maasijam/MONOFA/README.md

# MONOFA
A [Norns](https://monome.org/norns/) for Eurorack

It's based on a ["Fates Norns"](https://github.com/okyeron/fates) combined with an [Ornament & Crime](https://github.com/mxmxmx/O_C) (Captain Midi App) for Midi2CV and CV2Midi. The O_C ([MF-X2](MF-X2/)) has six additional gate outputs and a micro usb jack on the front panel. The [MF-X1](MF-X1/) boosts the norns signal to modular synth signal level and attenuates eurorack level to line level (for the norns input). The two expansion modules can be connected to the [MONOFA](MONOFA/) on the back.

|MONOFA|MF-X1|MF-X2|
|---|---|---|
|[Gerbers, BOM and images](MONOFA/)|[Gerbers, BOM and images](MF-X1/)|[Gerbers, BOM and images](MF-X2/)|

<br />

**Disclaimer**: This is a DIY project. Use at your own risk.<br />
<br /><br />
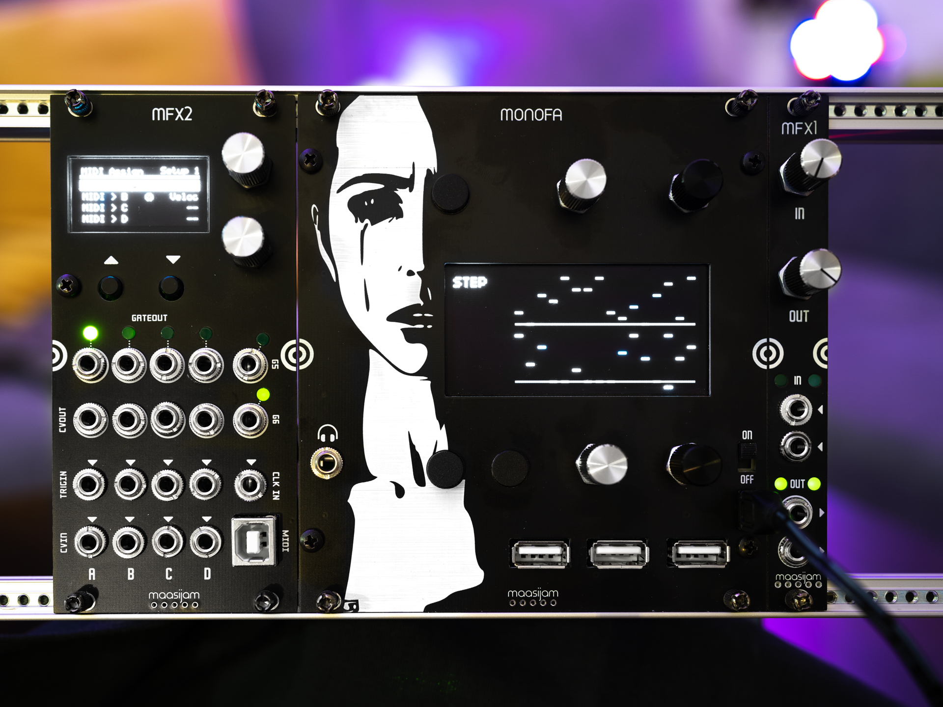
[picture p1: images/monofa_maasijam.jpg]
maasijam monofa


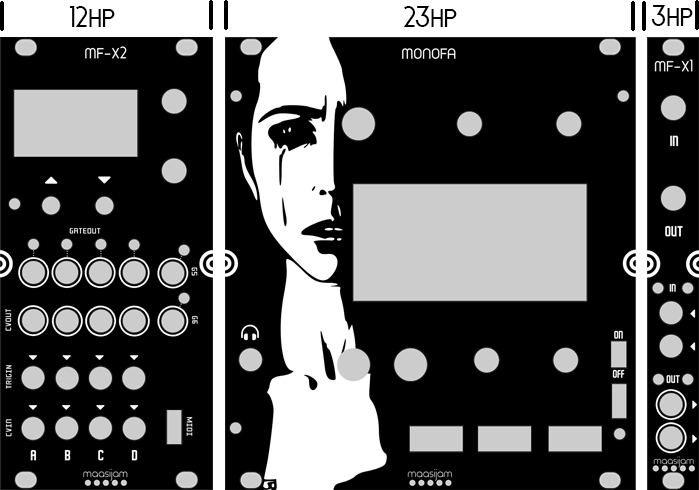
[picture p2: images/HPs.png]
maasijam monofa hp


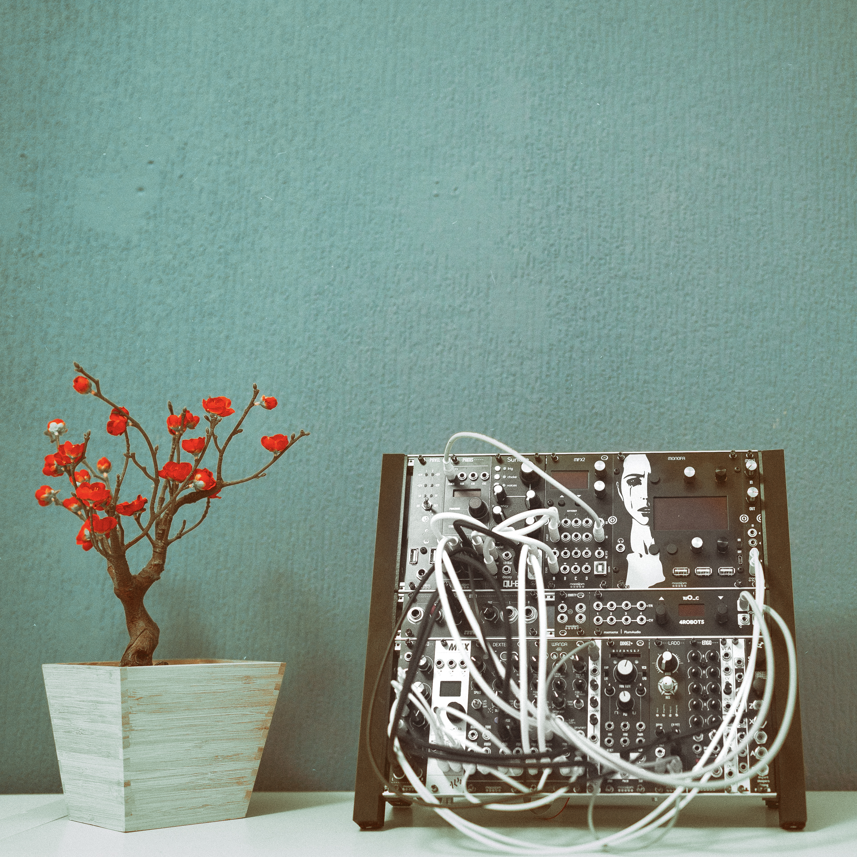
[picture p3: images/maasijam_monofa.jpg]
maasijam monofa
