maasijam/MONOFA/MF-X1/README.md

# MF-X1

Expander module for the MONOFA to boost line level to modular level and attenuates modular level to line level (for the MONOFA input). 
The MF-X1 can be connected to the MONOFA on the back.

### Notes:

This module only makes sense in combination with the [MONOFA](../MONOFA/) module.

<h3>Gerbers</h3>

[Gerber files for panel, front and back pcb](Gerber/)

<h3>BOM</h3>

[Bill of materials as CSV](BOM_mf-x1_v1.0revB.csv)
<br />
<br />

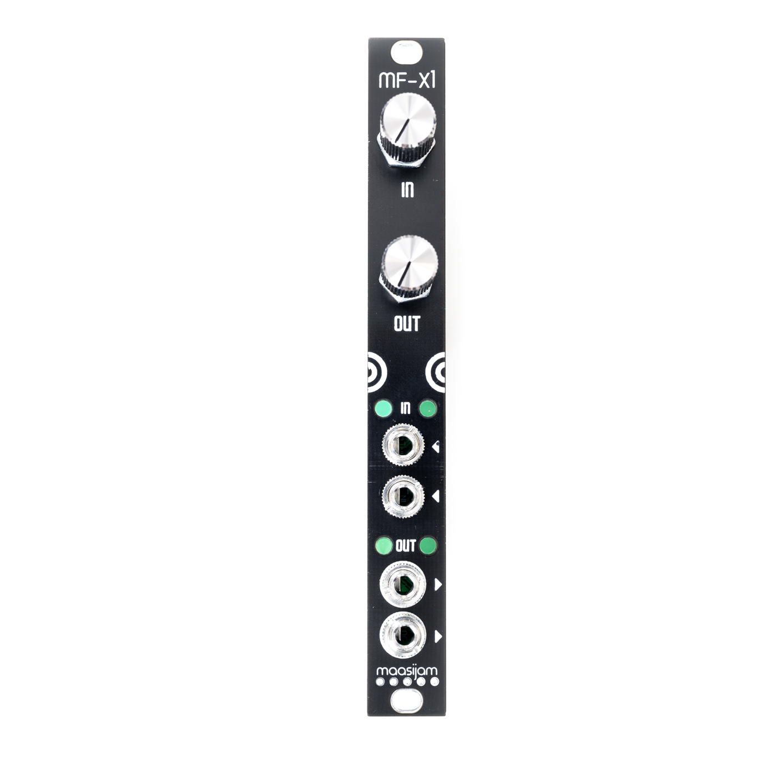
[picture p4: MF-X1/Images/mf-x1_maasijam-00307.jpg]
maasijam mf-x1


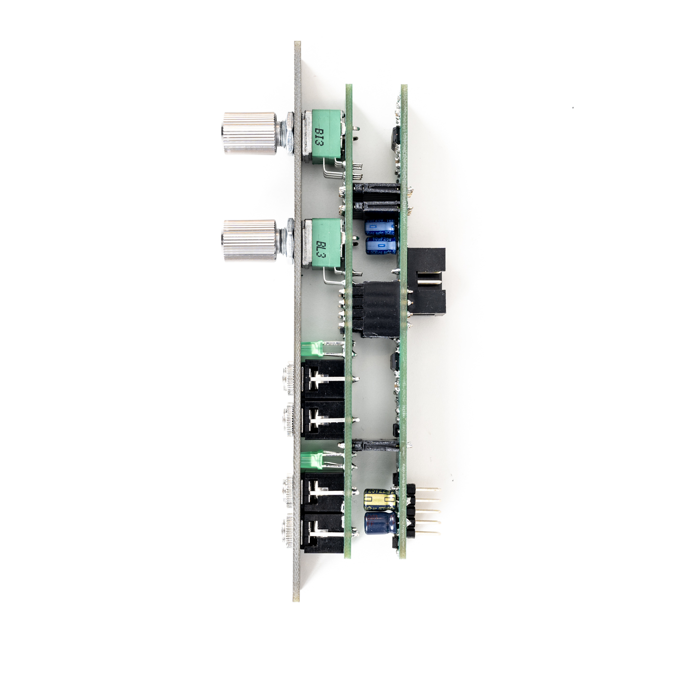
[picture p5: MF-X1/Images/mf-x1_maasijam-00308.jpg]
maasijam mf-x1


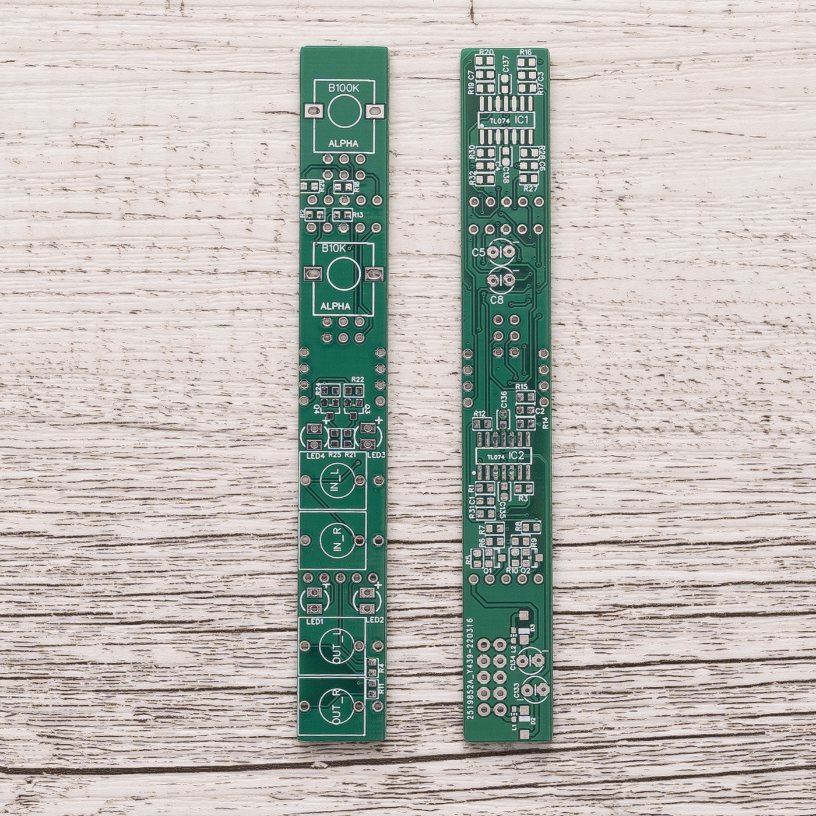
[picture p6: MF-X1/Images/mf-x1_maasijam-00284.jpg]
maasijam mf-x1
