maasijam/MONOFA/MONOFA/Readme.md

# MONOFA

A norns for eurorack.

### Notes:

You need the expander module [MF-X1](../MF-X1/) for stereo audio in and out. The two modules can be connected to each other on the back.

<h3>Gerbers</h3>

[Gerber files for panel, main and helper pcbs](Gerber/)
<br />

<h3>BOM</h3>

[Bill of materials as CSV](BOM_monofa_v1.0_revE.csv)
<br />

<br />

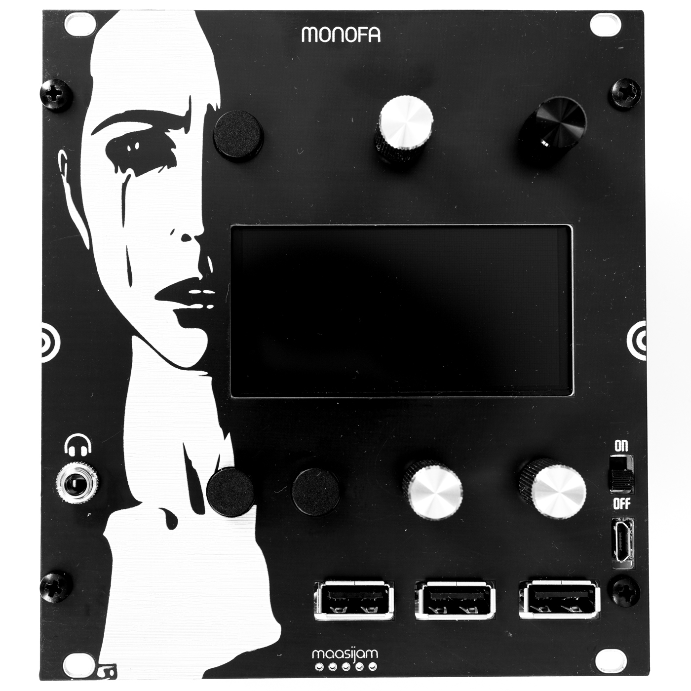
[picture p7: MONOFA/Images/monofa_maasijam-00364.jpg]
maasijam monofa


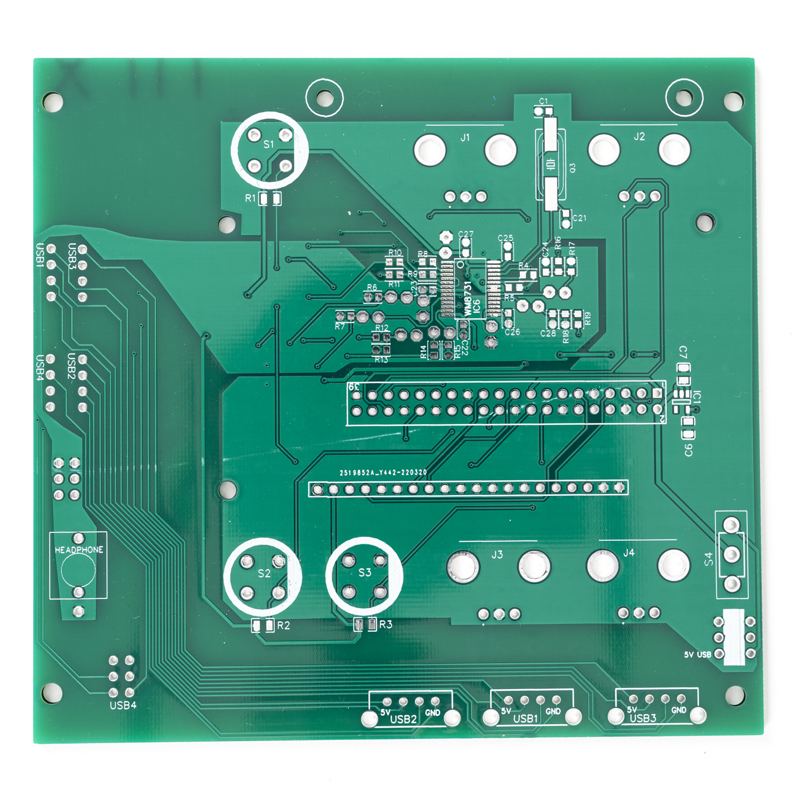
[picture p8: MONOFA/Images/monofa_maasijam-00362.jpg]
maasijam monofa


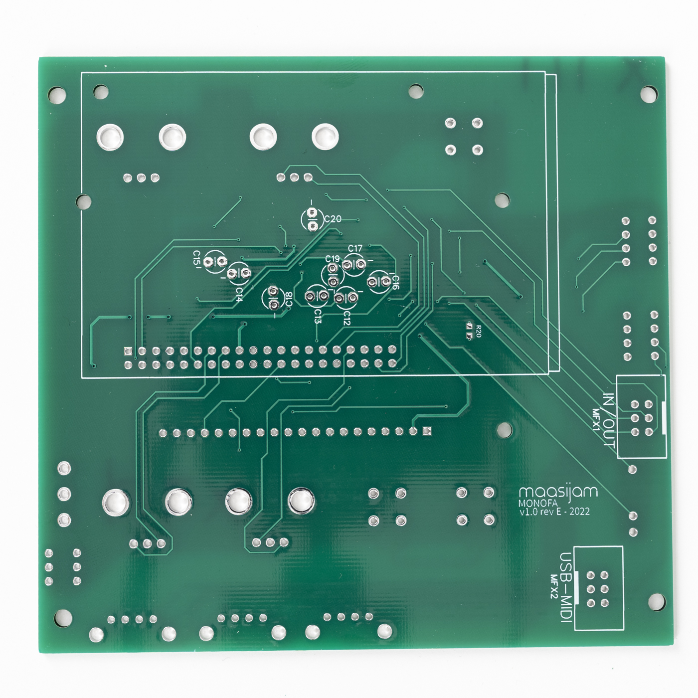
[picture p9: MONOFA/Images/monofa_maasijam-00363.jpg]
maasijam monofa


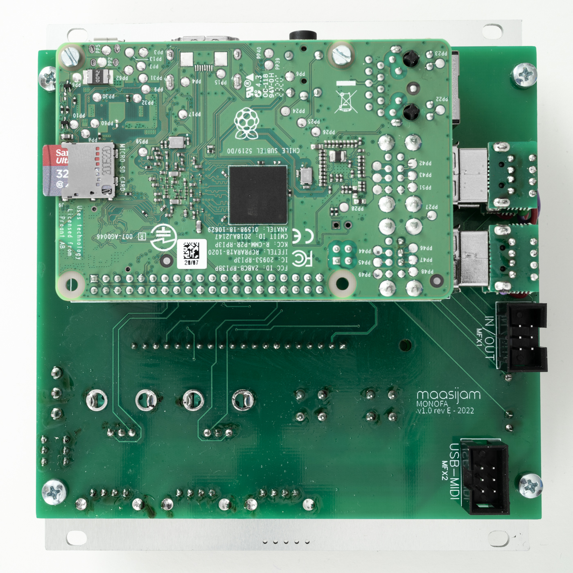
[picture p10: MONOFA/Images/monofa_maasijam-00365.jpg]
maasijam monofa


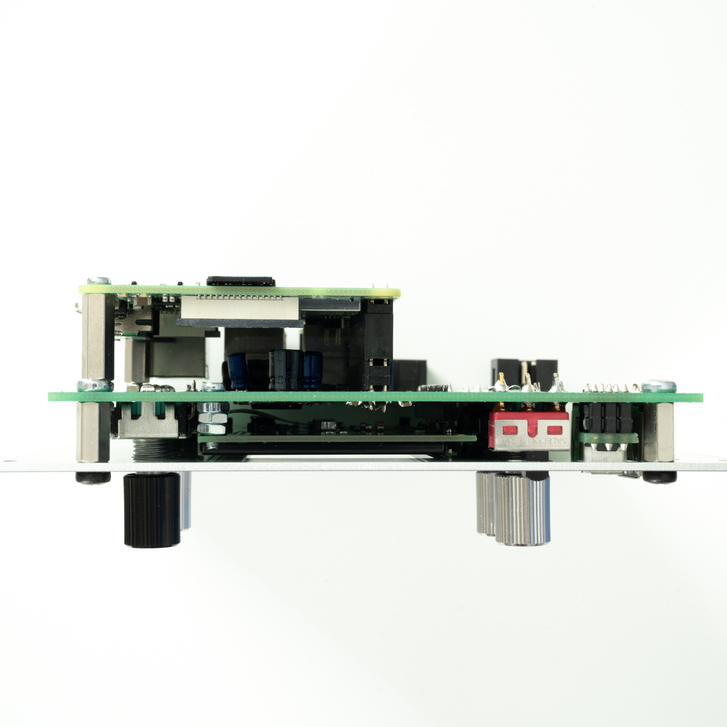
[picture p11: MONOFA/Images/monofa_maasijam-00366.jpg]
maasijam monofa


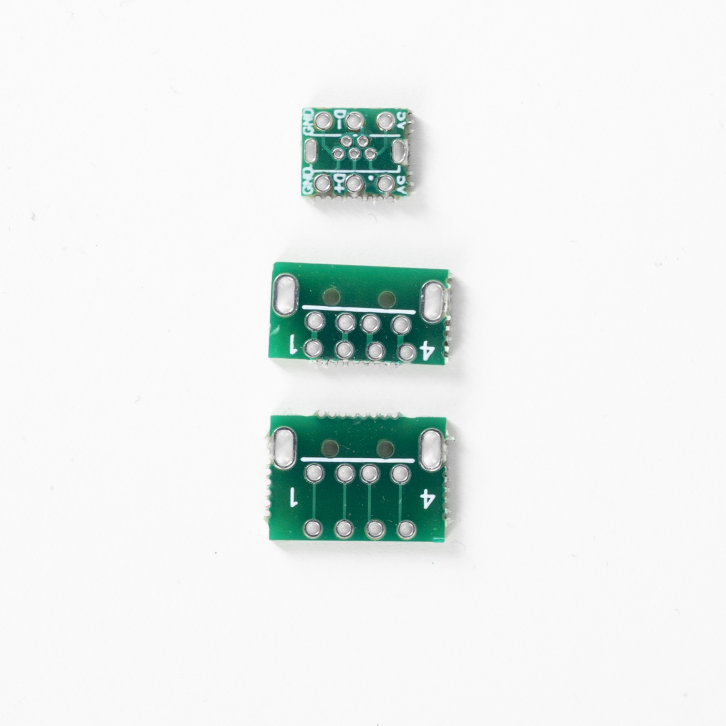
[picture p12: MONOFA/Images/monofa_maasijam-00367.jpg]
maasijam monofa
