maasijam/MONOFA/MF-X2/Readme.md

# MF-X2

Expander module for the [MONOFA](../MONOFA/) for MIDI2CV and CV2MIDI. It's an extended [Ornament & Crime](https://github.com/mxmxmx/O_C) (six additional gate outs, micro usb jack on the front panel). The MF-X2 can be connected to the [MONOFA](../MONOFA/) on the back. 

<h3>Gerbers</h3>

[Gerber files for panel, front pcb](Gerbers/)

<h3>BOM</h3>

[Bill of materials as CSV](BOM_mfx2_front_v1.1_revB_2022-04-13.csv)
<br />

<h3>Schematic</h3>

[Schematic](Schematic_MFX2_2026-03-30.pdf)
<br />

<br />

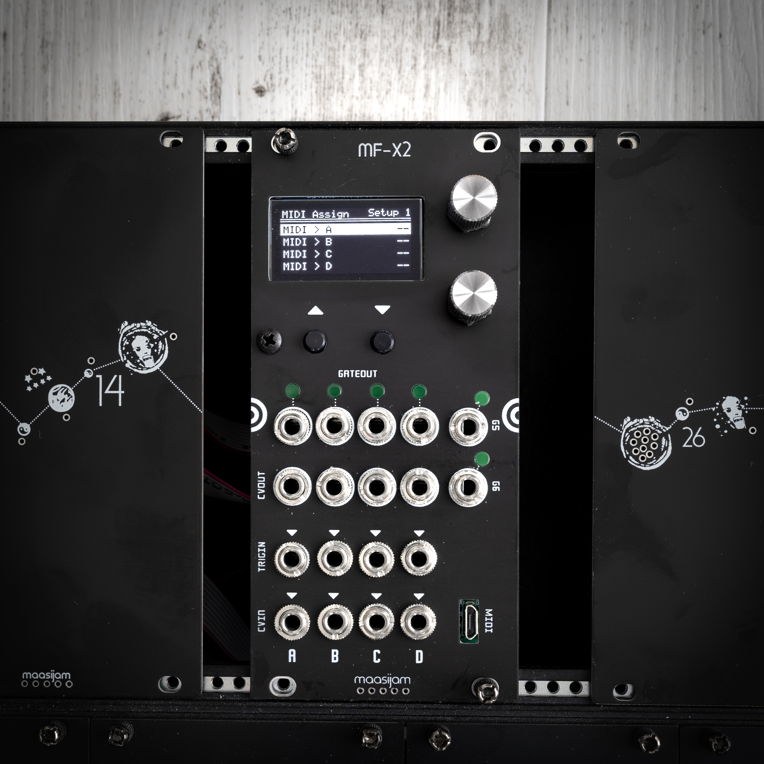
[picture p13: MF-X2/Images/mf-x2_screen.jpg]


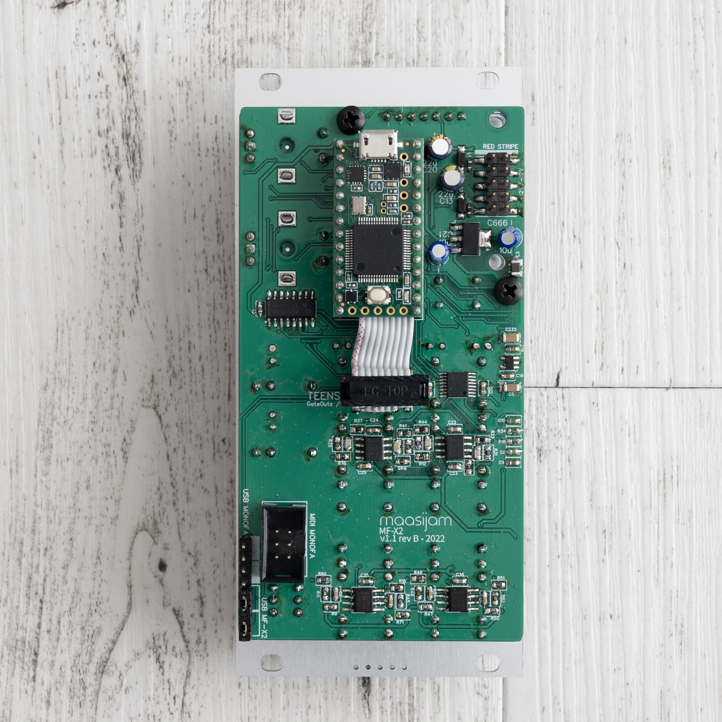
[picture p14: MF-X2/Images/mf-x2_pcb_back.jpg]


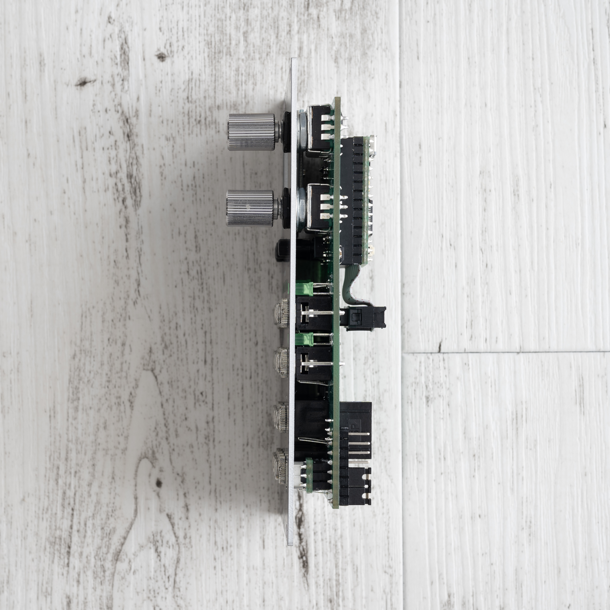
[picture p15: MF-X2/Images/mf-x2_pcb_side.jpg]


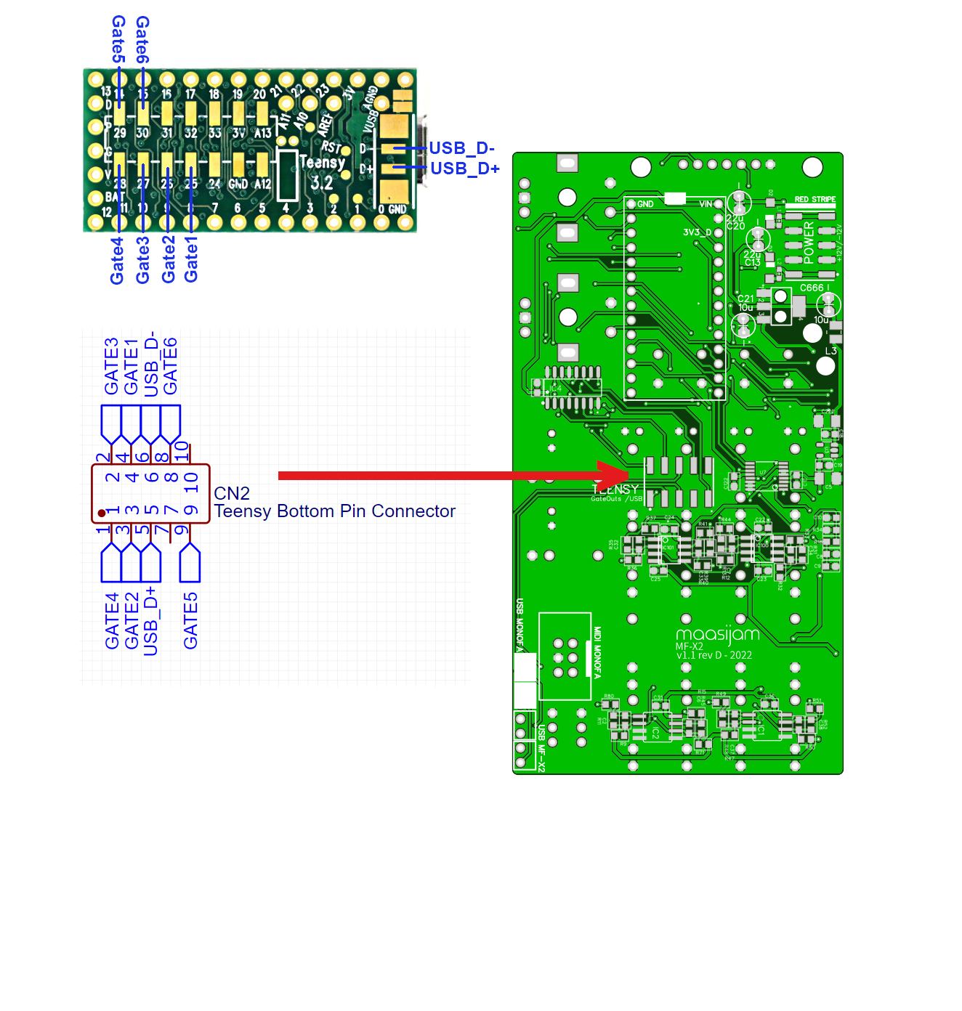
[picture p16: MF-X2/Images/mf-x2_gate_connector.jpg]
