maasijam/MONOFA/MONOFA/Gerber/README.md

# MONOFA Gerber Files

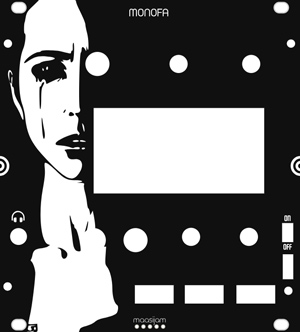
[picture p17: MONOFA/Images/monofa_panel_screen.jpg]
 [Gerber_monofa_panel](Gerber_monofa_panel_v001_revE_2022-04-25.zip)<br clear="left"/>

---
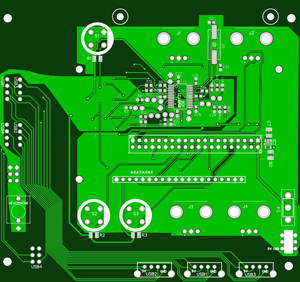
[picture p18: MONOFA/Images/main_pcb_screen.jpg]
 [Gerber_monofa_front](Gerber_MONOFA_monofa_front_v1.0_revF_2026-04-02.zip)<br clear="left"/>

---
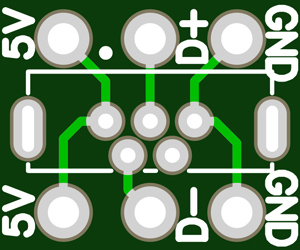
[picture p19: MONOFA/Images/usb_power_screen.jpg]
 [Gerber_monofa_usb_power](Gerber_monofa_usb_power_revB_2022-04-25.zip)<br clear="left"/>

---
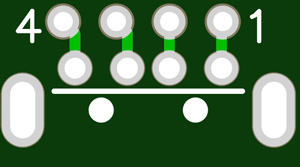
[picture p20: MONOFA/Images/usb_connector_screen.jpg]
 [Gerber_monofa_usb_connector](Gerber_monofa_usb_connector_2022-04-25.zip)<br clear="left"/>

---
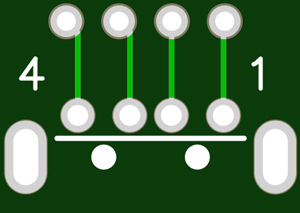
[picture p21: MONOFA/Images/usb_connector_big_screen.jpg]
 [Gerber_monofa_usb_connector_big](Gerber_monofa_usb_connector_big_2022-04-25.zip)<br clear="left"/>
