maasijam/MONOFA/MF-X2/Gerbers/README.md

# MF-X2 Gerber Files

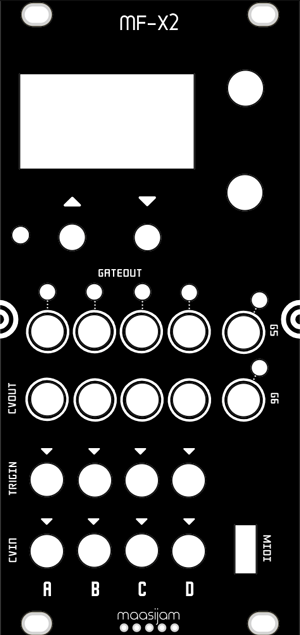
[picture p22: MF-X2/Images/mf-x2_panel_screen.png]
 [Gerber_mf-x2_panel](Gerber_mfx2_panel_v1.1_revB.zip)<br clear="left"/>

---
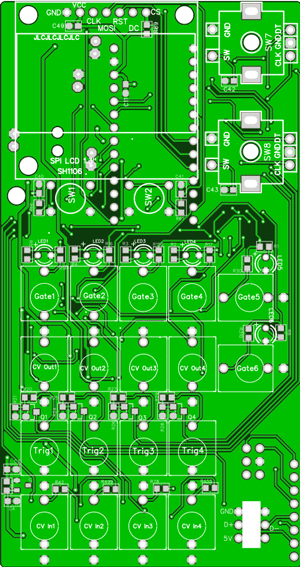
[picture p23: MF-X2/Images/mf-x2_frontpcb_screen.png]
 [Gerber_mf-x2_front](Gerber_mfx2_front_v1.1_revD.zip)<br clear="left"/>

---
**Notes:**
The following pcb will also used in the [MONOFA](../../MONOFA/) module. So, if you want to build both modules, you may only need one order (because of the minimum number of pcbs you often have to order).

 [Gerber_monofa/mf-x2_usb](../../MONOFA/Gerber/Gerber_monofa_usb_power_revB_2022-04-25.zip)<br clear="left"/>
