maasijam/MONOFA/MF-X1/Gerber/README.md

# MF-X1 Gerber Files

| PANEL | FRONT | BACK |
| --- | --- | --- |
|  [Gerber_mf-x1_panel](Gerber_mfx1_panel_v1.0_revB_2022-04-10.zip) |  [Gerber_mf-x1_front](Gerber_mfx1_front_v1.0_revB_2022-04-10.zip) |  [Gerber_mf-x1_back](Gerber_mfx1_back_v1.0_revB.zip) |
