maasijam/MONOFA/MF-X1/Images/mf-x1_maasijam-00299.jpg

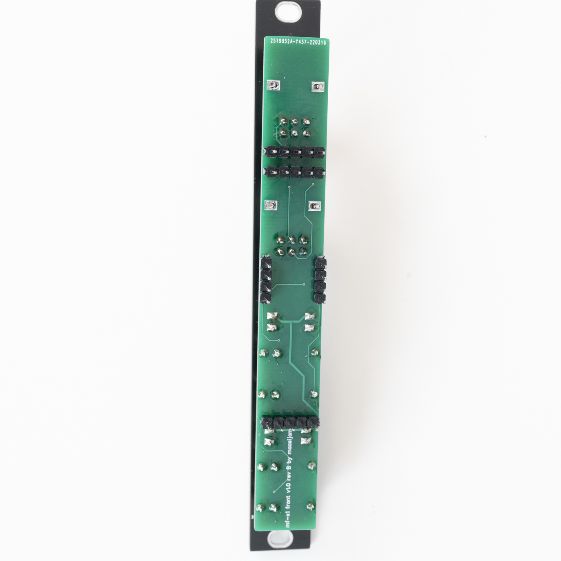
MF-X1/Images/mf-x1_maasijam-00299.jpg
