maasijam/MONOFA/MF-X1/Images/mf-x1_maasijam-00301.jpg

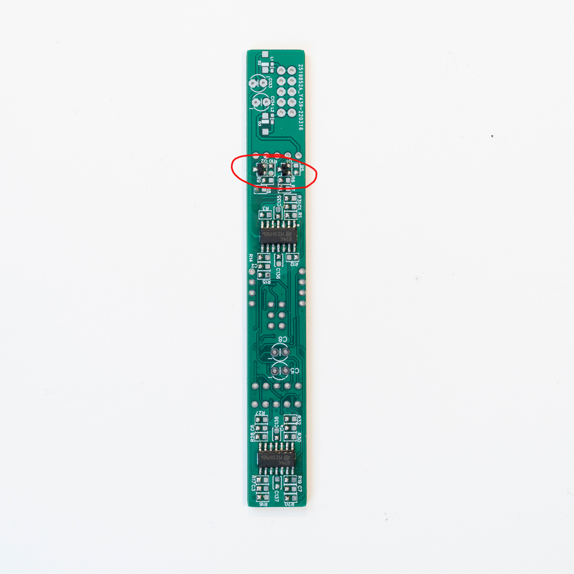
MF-X1/Images/mf-x1_maasijam-00301.jpg
