maasijam/MONOFA/MONOFA/Images/monofa_maasijam-00343.jpg

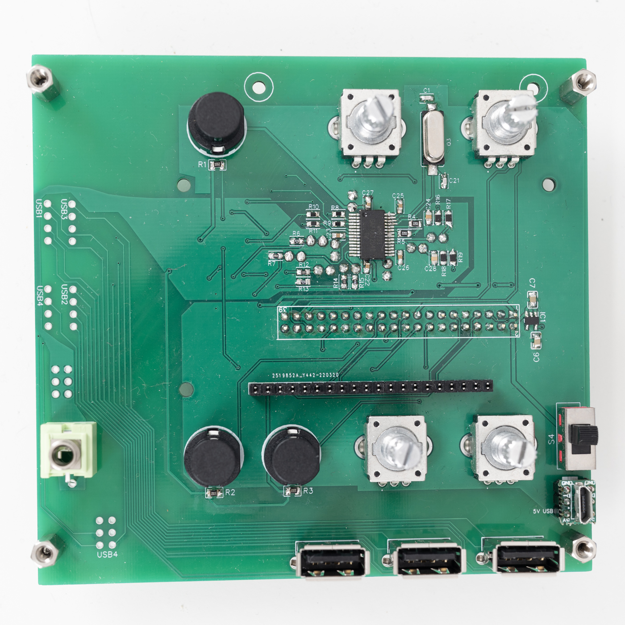
MONOFA/Images/monofa_maasijam-00343.jpg
