maasijam/MONOFA/MONOFA/Images/monofa_maasijam-00344.jpg

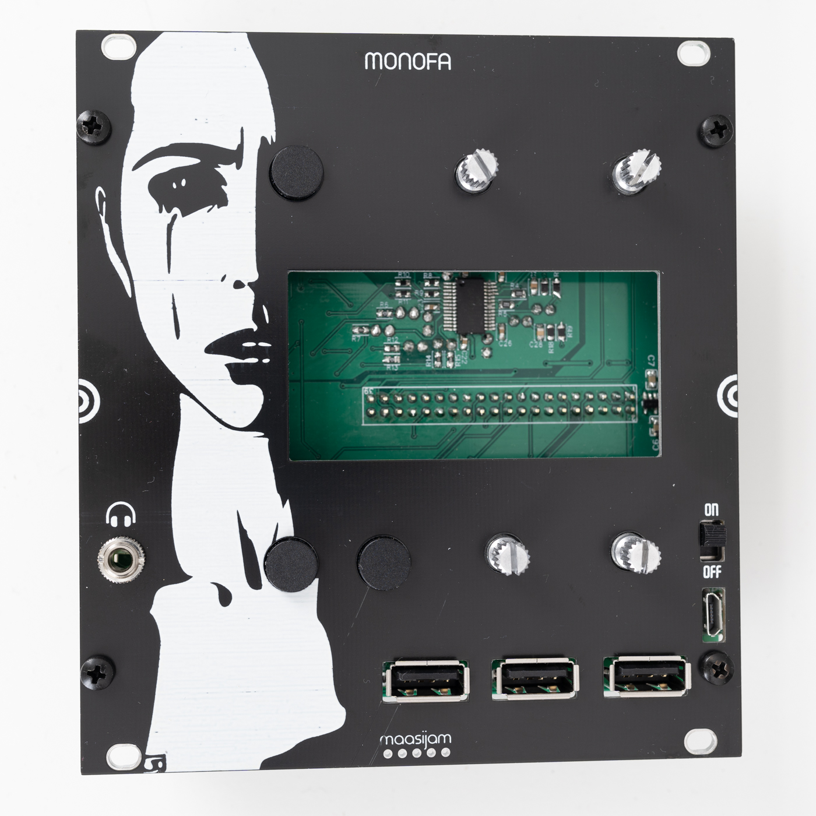
MONOFA/Images/monofa_maasijam-00344.jpg
