maasijam/MONOFA/MONOFA/Images/monofa_maasijam-00345.jpg

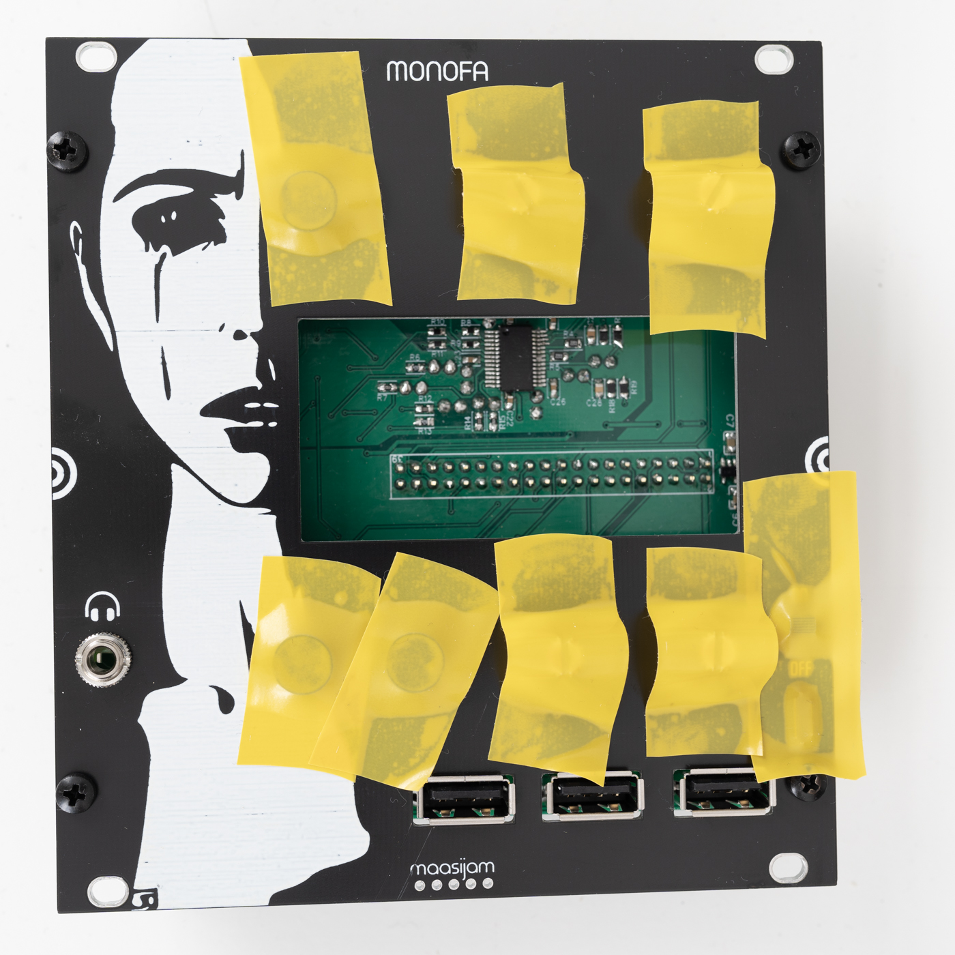
MONOFA/Images/monofa_maasijam-00345.jpg
