maasijam/MONOFA/MONOFA/Images/monofa_maasijam-00346.jpg

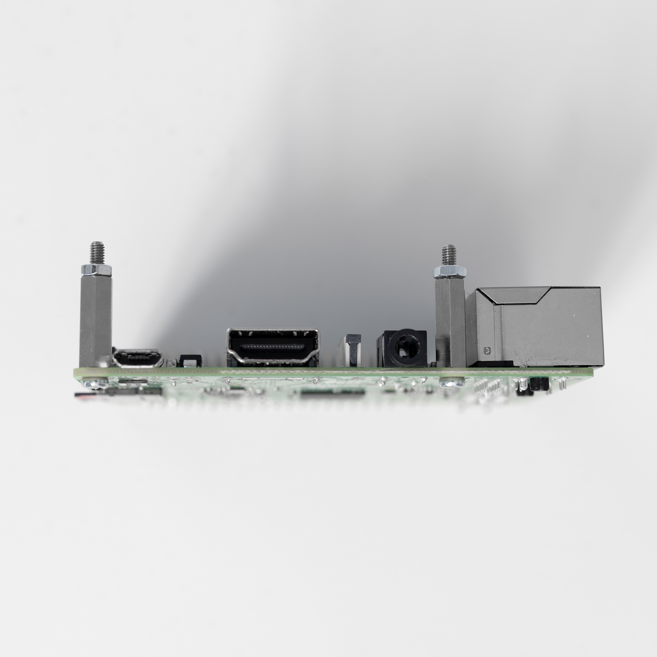
MONOFA/Images/monofa_maasijam-00346.jpg
