maasijam/MONOFA/MONOFA/Images/monofa_maasijam-00347.jpg

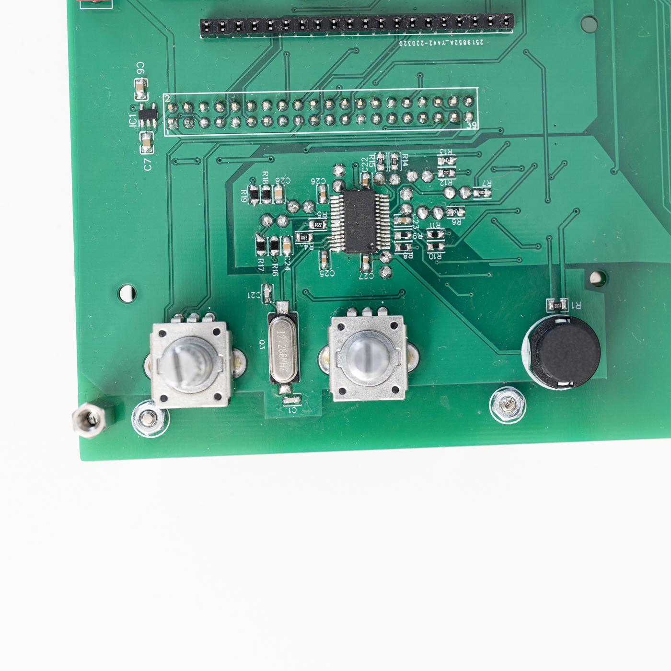
MONOFA/Images/monofa_maasijam-00347.jpg
