maasijam/MONOFA/MONOFA/Images/monofa_maasijam-00348.jpg

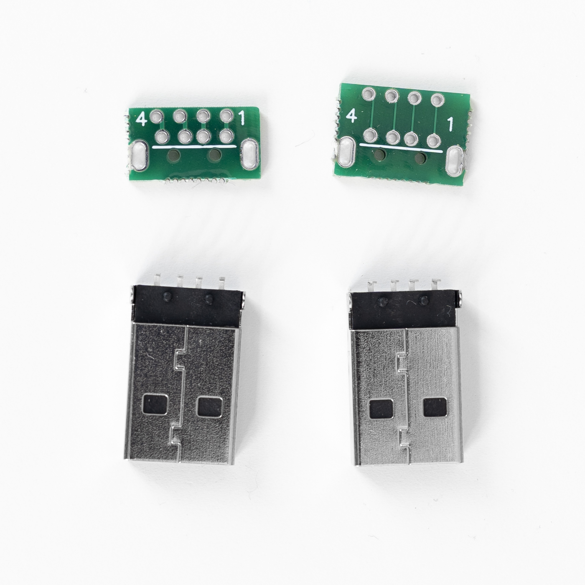
MONOFA/Images/monofa_maasijam-00348.jpg
