maasijam/MONOFA/MONOFA/Images/monofa_maasijam-00349.jpg

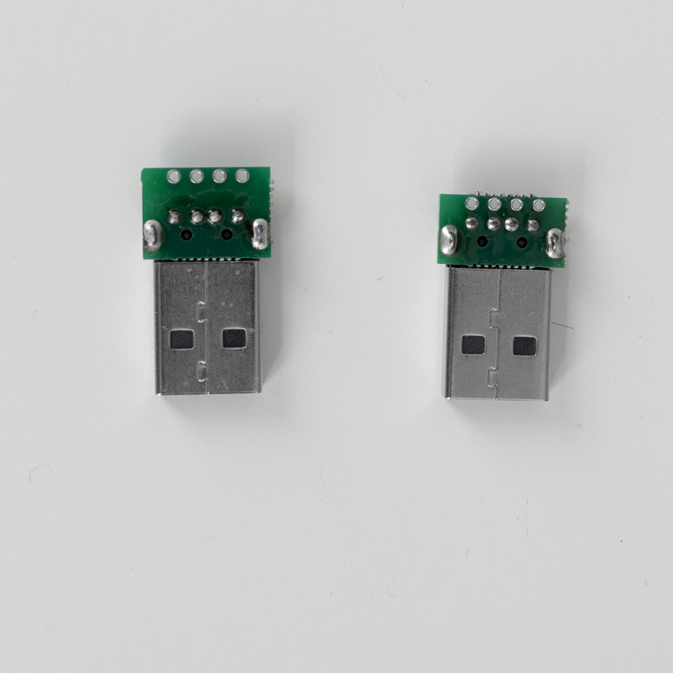
MONOFA/Images/monofa_maasijam-00349.jpg
