maasijam/MONOFA/MONOFA/Images/monofa_maasijam-00350.jpg

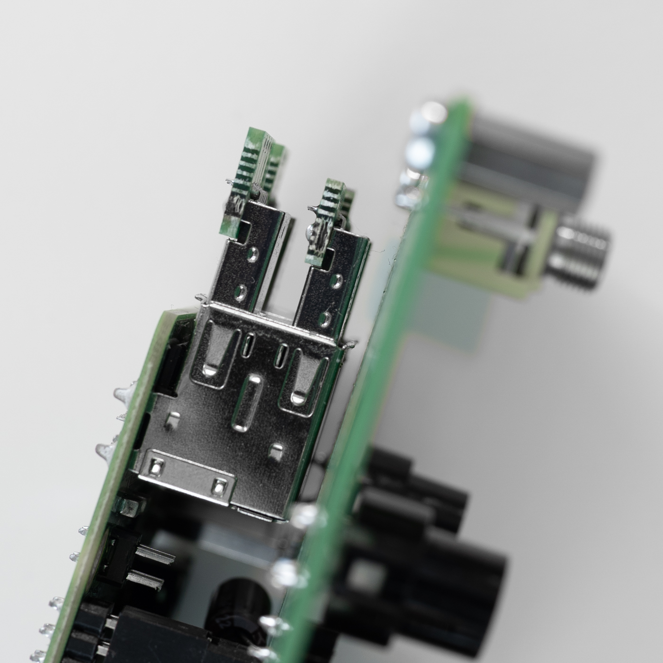
MONOFA/Images/monofa_maasijam-00350.jpg
