maasijam/MONOFA/MONOFA/Images/monofa_maasijam-00352.jpg

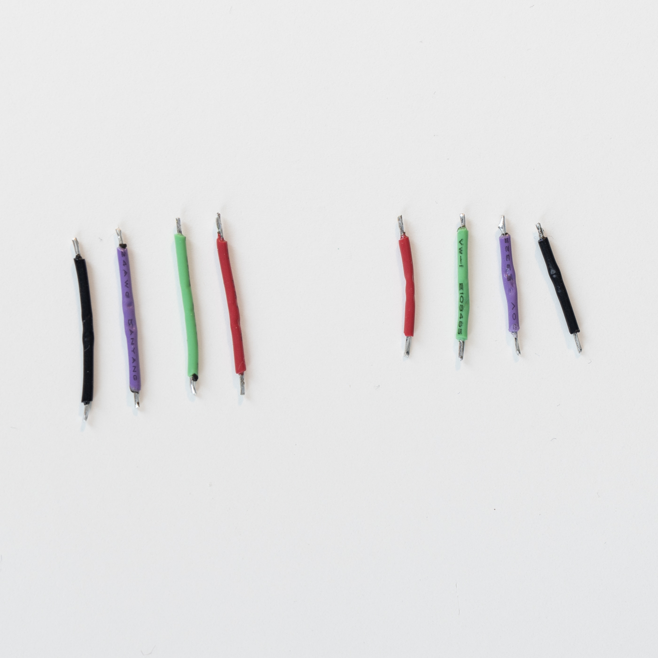
MONOFA/Images/monofa_maasijam-00352.jpg
