maasijam/MONOFA/MONOFA/Images/monofa_maasijam-00353.jpg

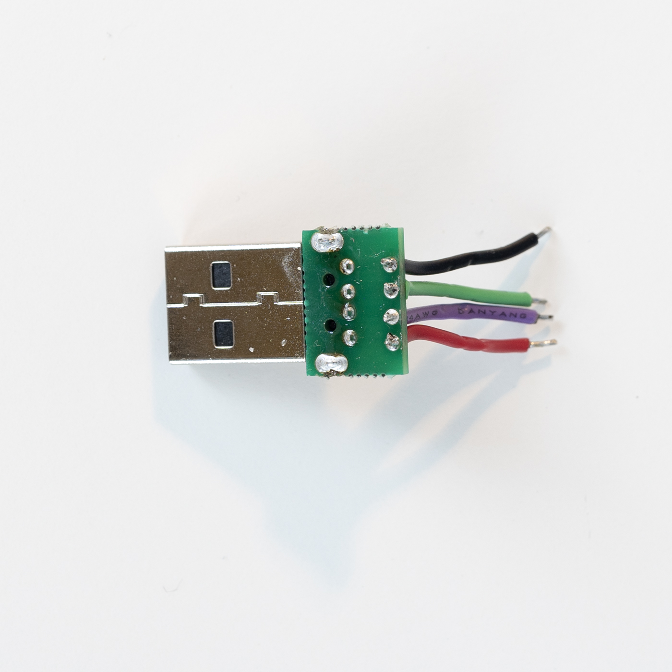
MONOFA/Images/monofa_maasijam-00353.jpg
