maasijam/MONOFA/MONOFA/Images/monofa_maasijam-00354.jpg

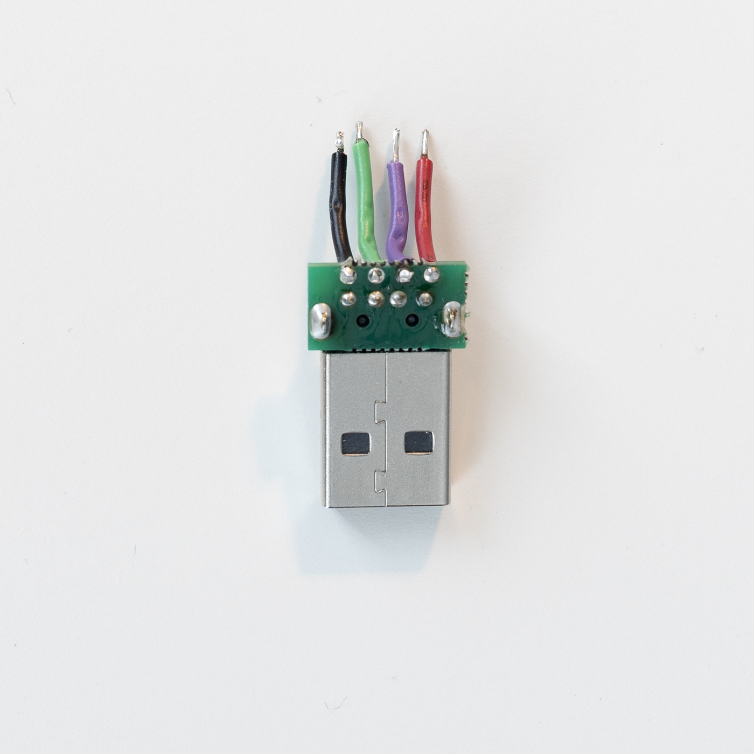
MONOFA/Images/monofa_maasijam-00354.jpg
