maasijam/MONOFA/MONOFA/Images/monofa_maasijam-00355.jpg

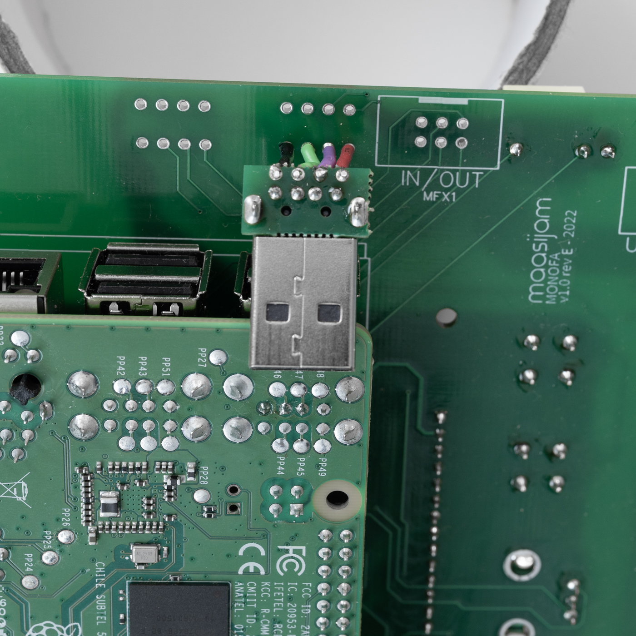
MONOFA/Images/monofa_maasijam-00355.jpg
