maasijam/MONOFA/MONOFA/Images/monofa_maasijam-00356.jpg

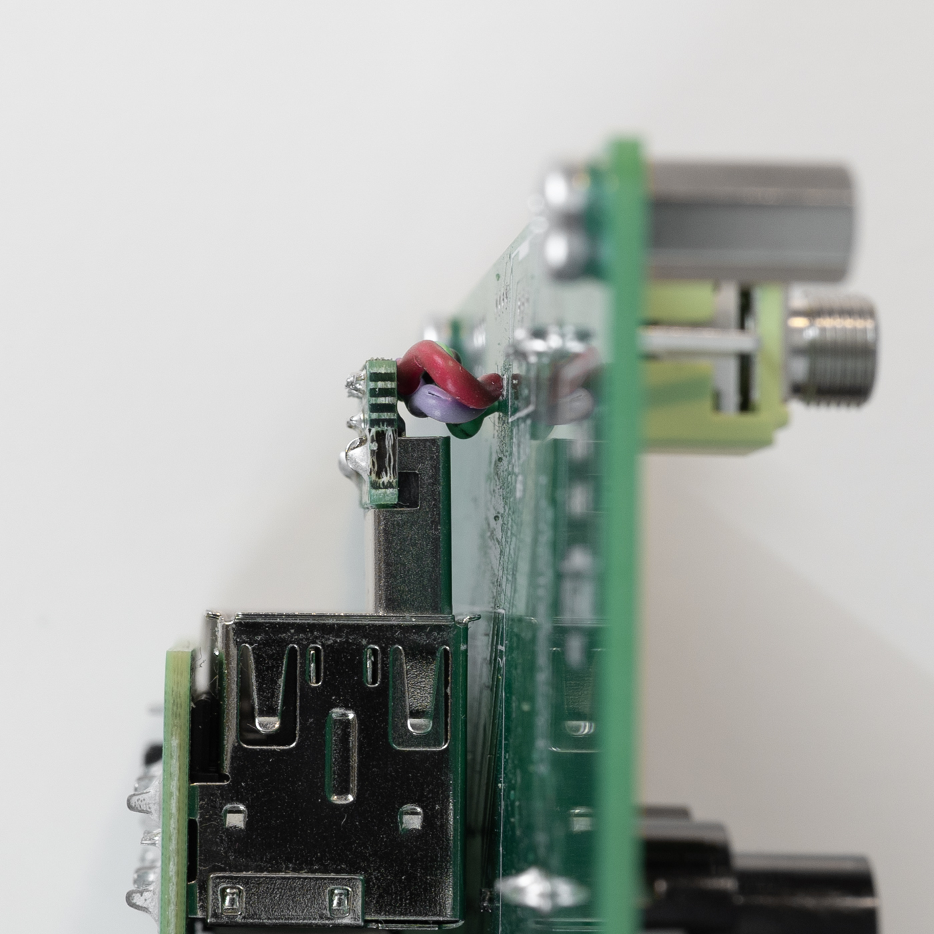
MONOFA/Images/monofa_maasijam-00356.jpg
