maasijam/MONOFA/MONOFA/Images/monofa_maasijam-00357.jpg

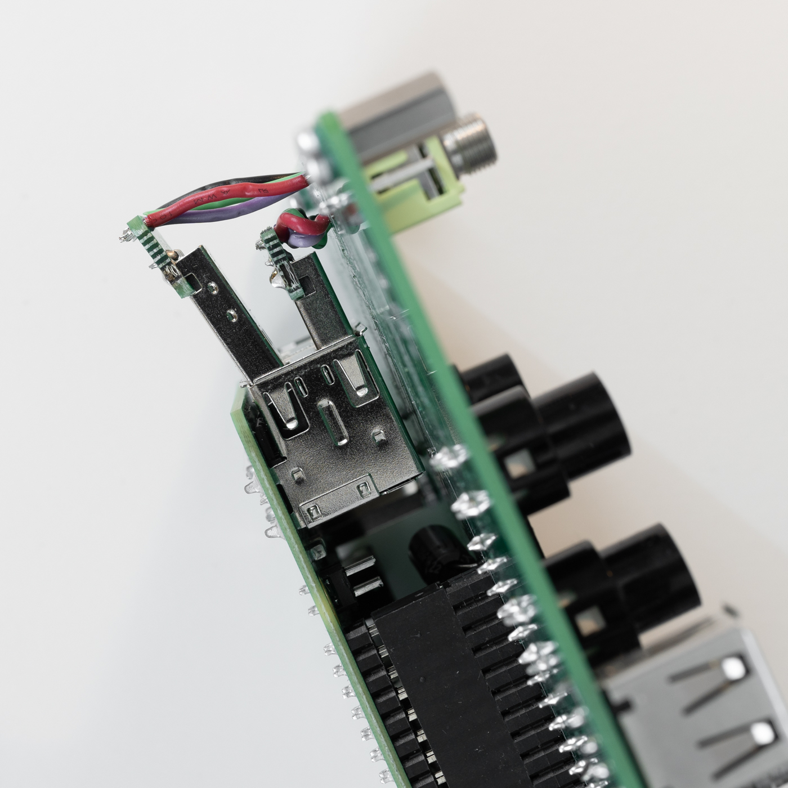
MONOFA/Images/monofa_maasijam-00357.jpg
