maasijam/MONOFA/MONOFA/Images/monofa_maasijam-00358.jpg

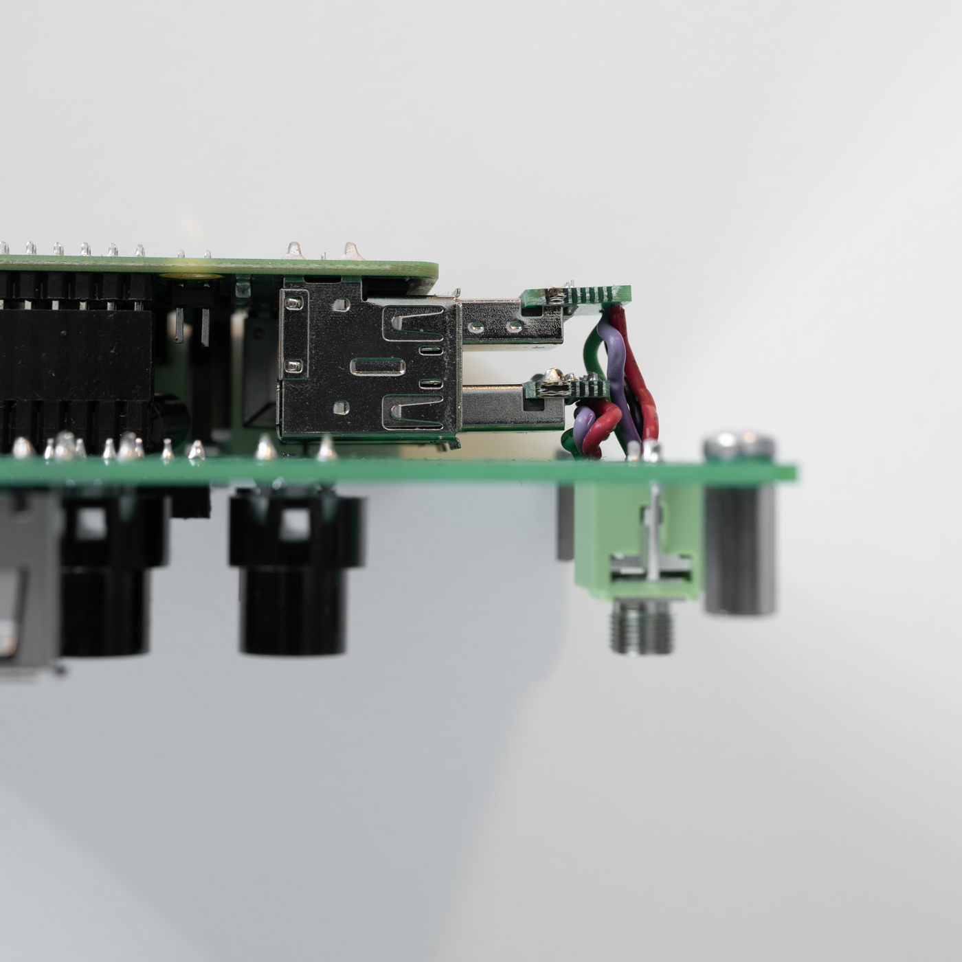
MONOFA/Images/monofa_maasijam-00358.jpg
