maasijam/MONOFA/MONOFA/Images/monofa_maasijam-00359.jpg

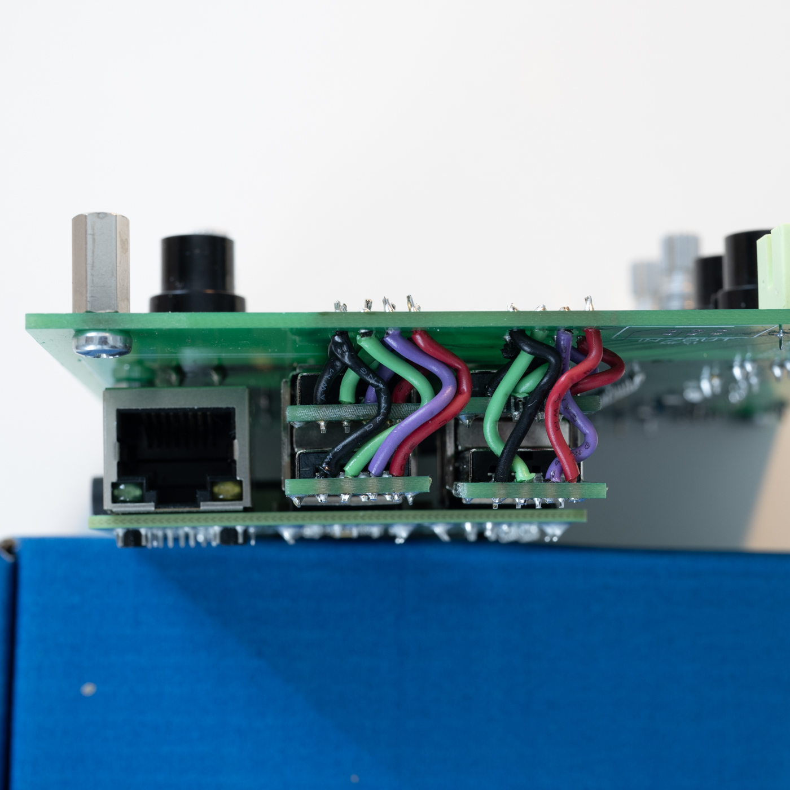
MONOFA/Images/monofa_maasijam-00359.jpg
