maasijam/MONOFA/MONOFA/Images/monofa_maasijam-00360.jpg

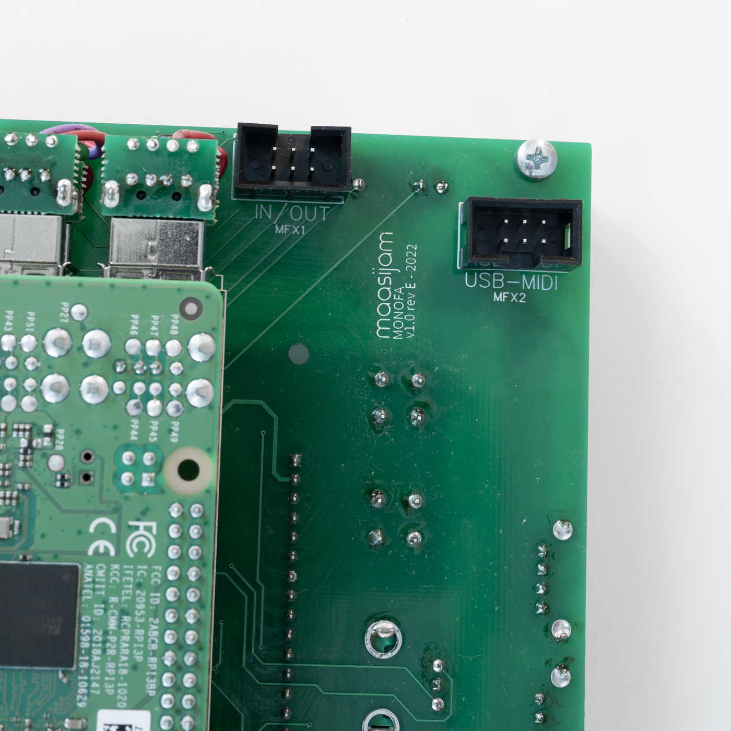
MONOFA/Images/monofa_maasijam-00360.jpg
