maasijam/MONOFA/MONOFA/Images/monofa_maasijam-00361.jpg

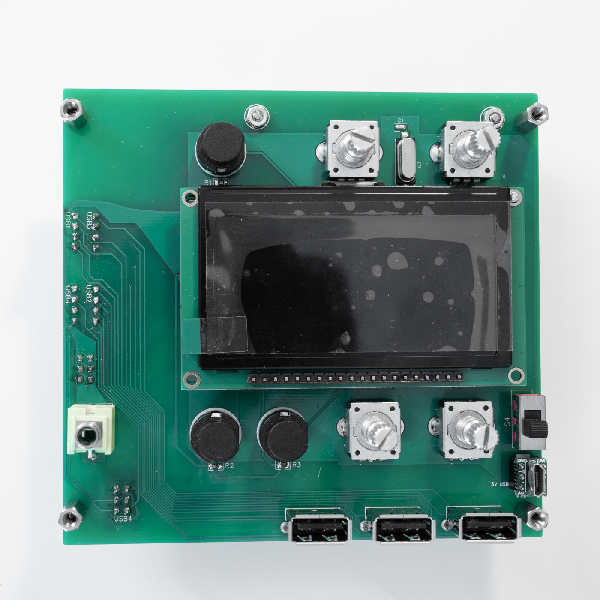
MONOFA/Images/monofa_maasijam-00361.jpg
