maasijam/MONOFA/MF-X2/Schematic_MFX2_2026-03-30.pdf

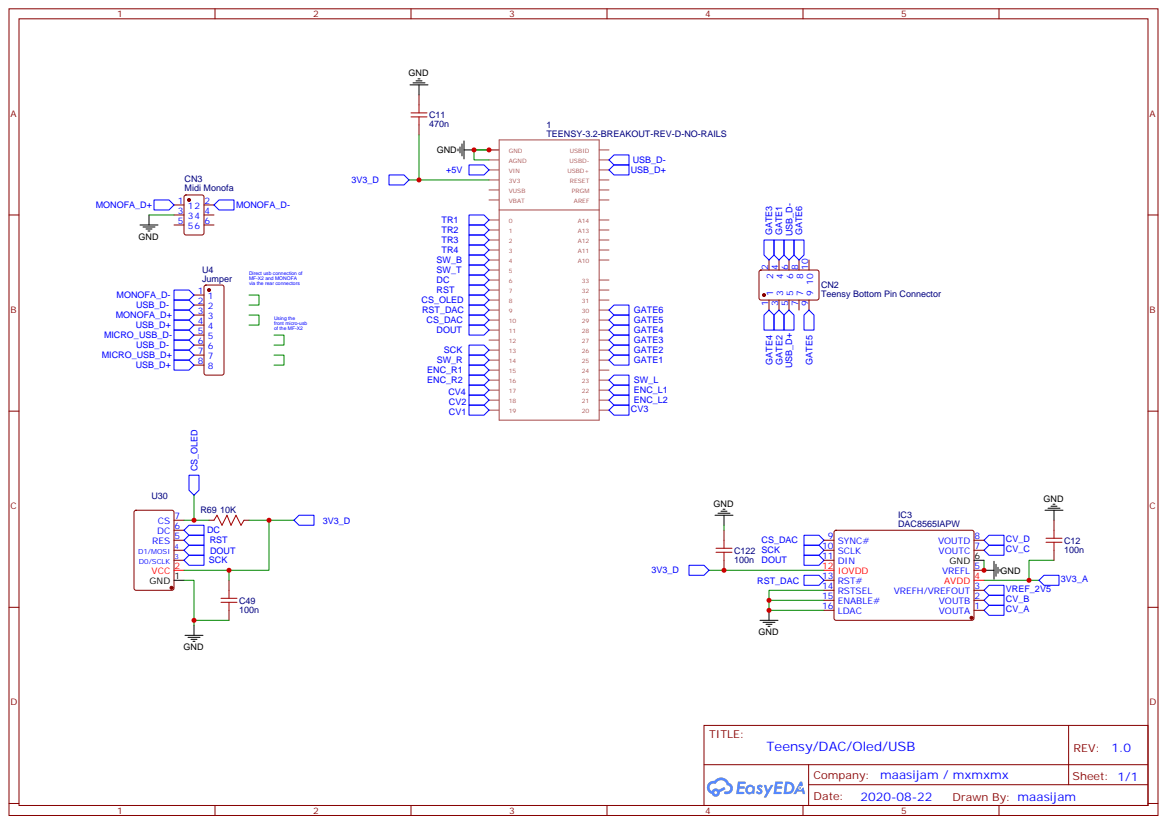
[picture p54: page 1]

TEENSY-3.2-BREAKOUT-REV-D-NO-RAILS

Direct usb connection of
MF-X2 and MONOFA
via the rear connectors

CV In 1 | CV1
CV In 2 | CV2

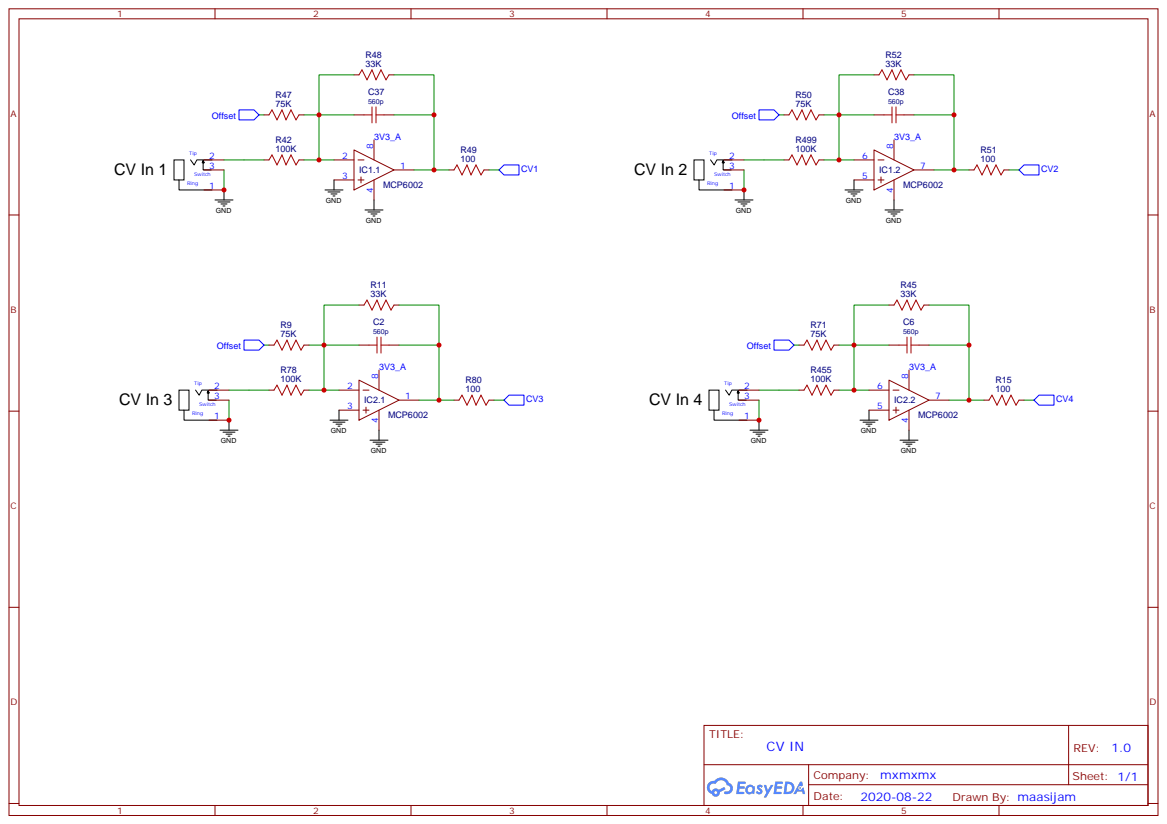
[picture p55: page 2]

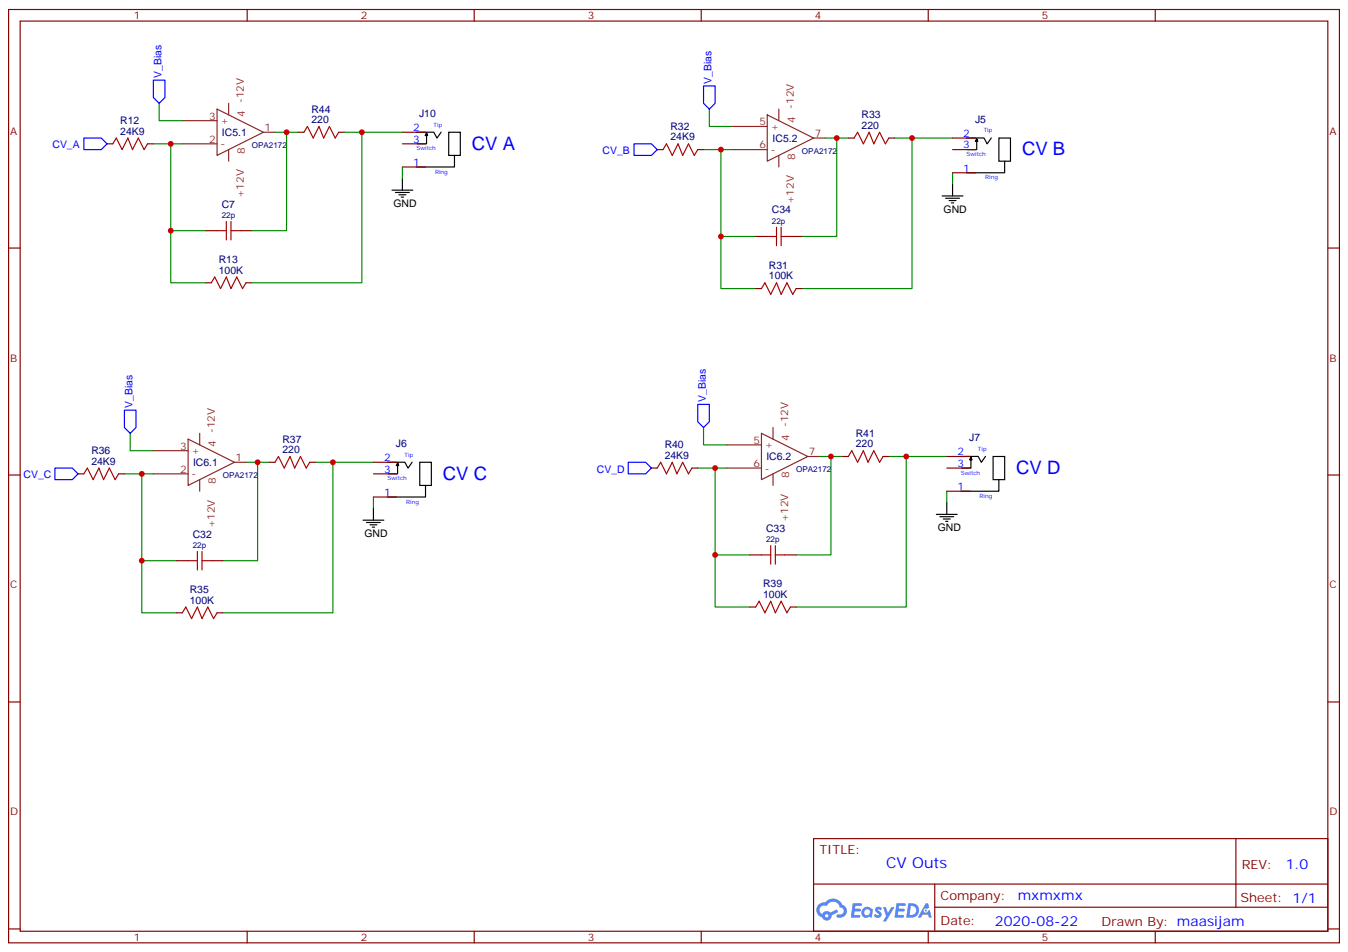
[picture p56: page 3]

# TRIGGER/GATE1

# TRIGGER/GATE2

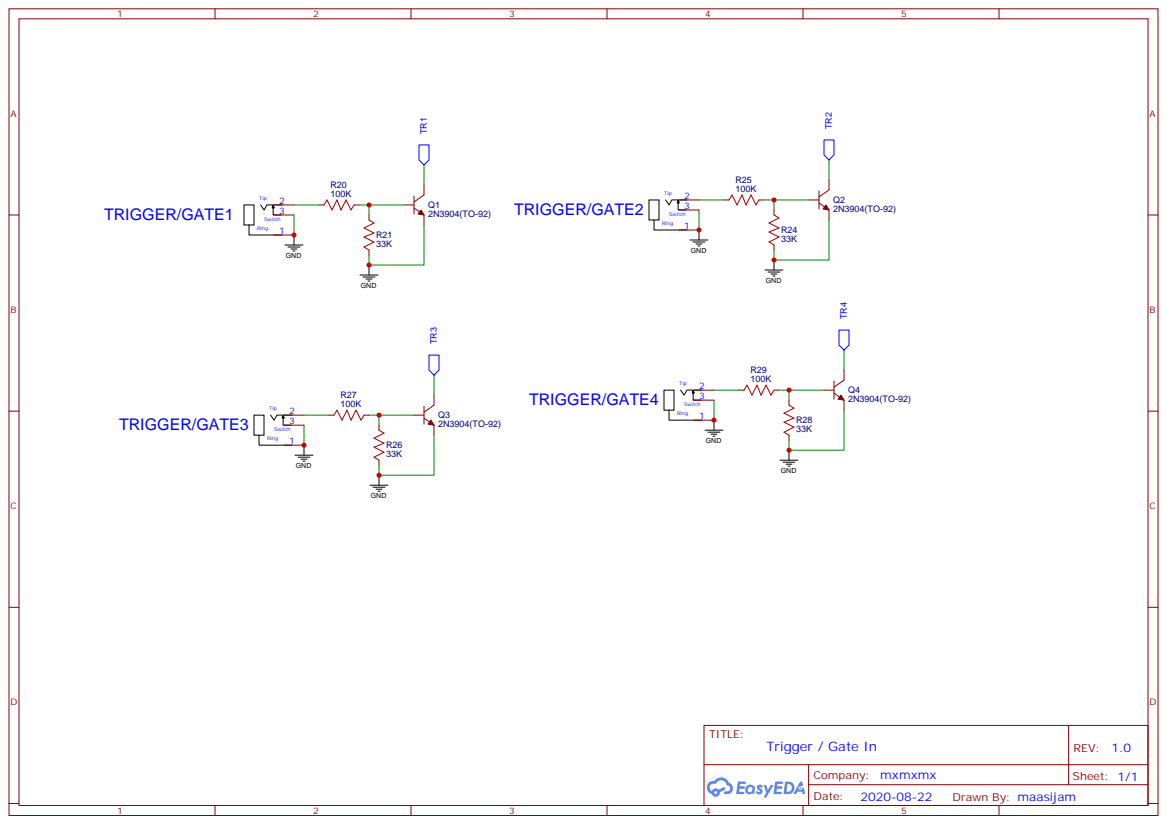
[picture p57: page 4]

## GATE1 GATE2

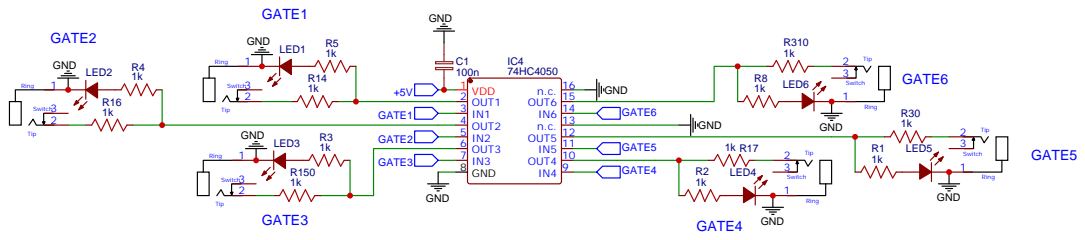
[picture p58: page 5]

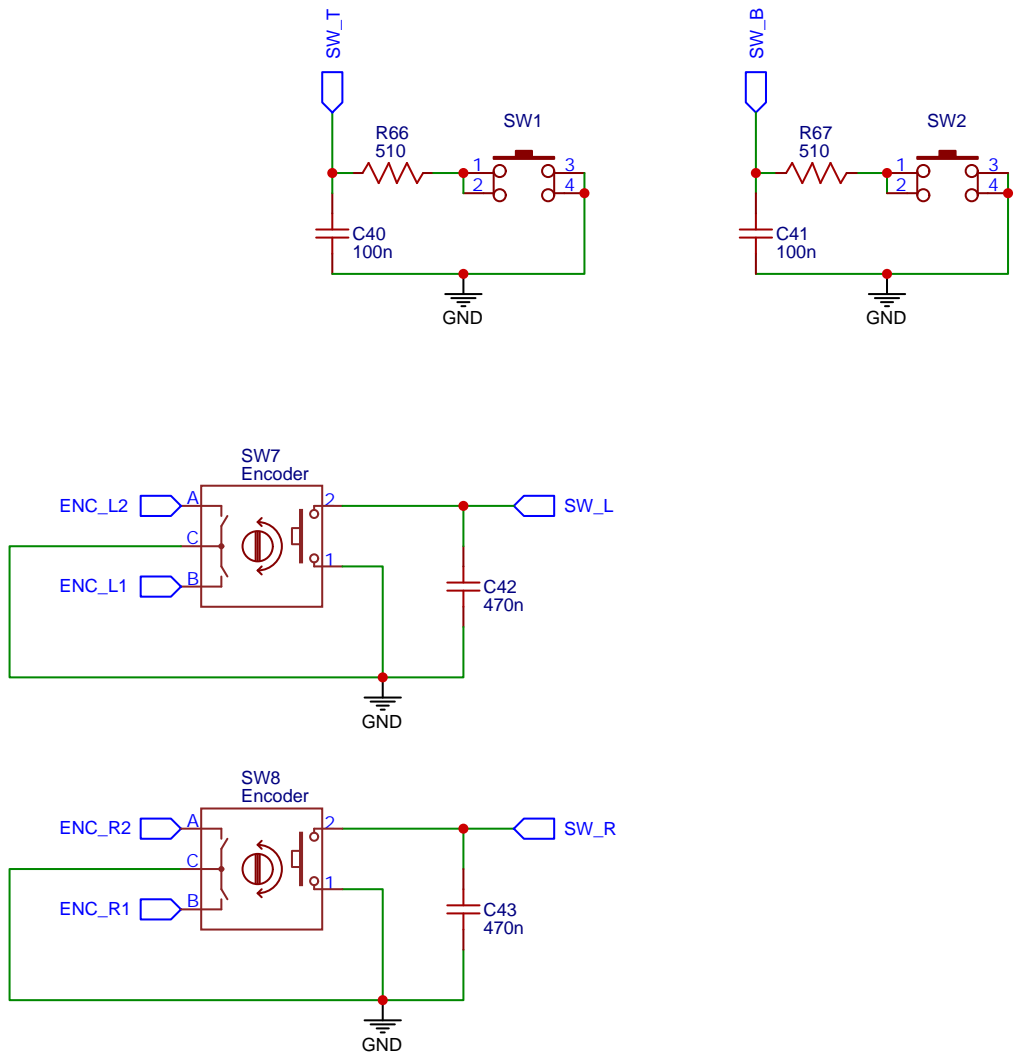
[picture p59: page 6]

## VCC +12V

## VCC +12V

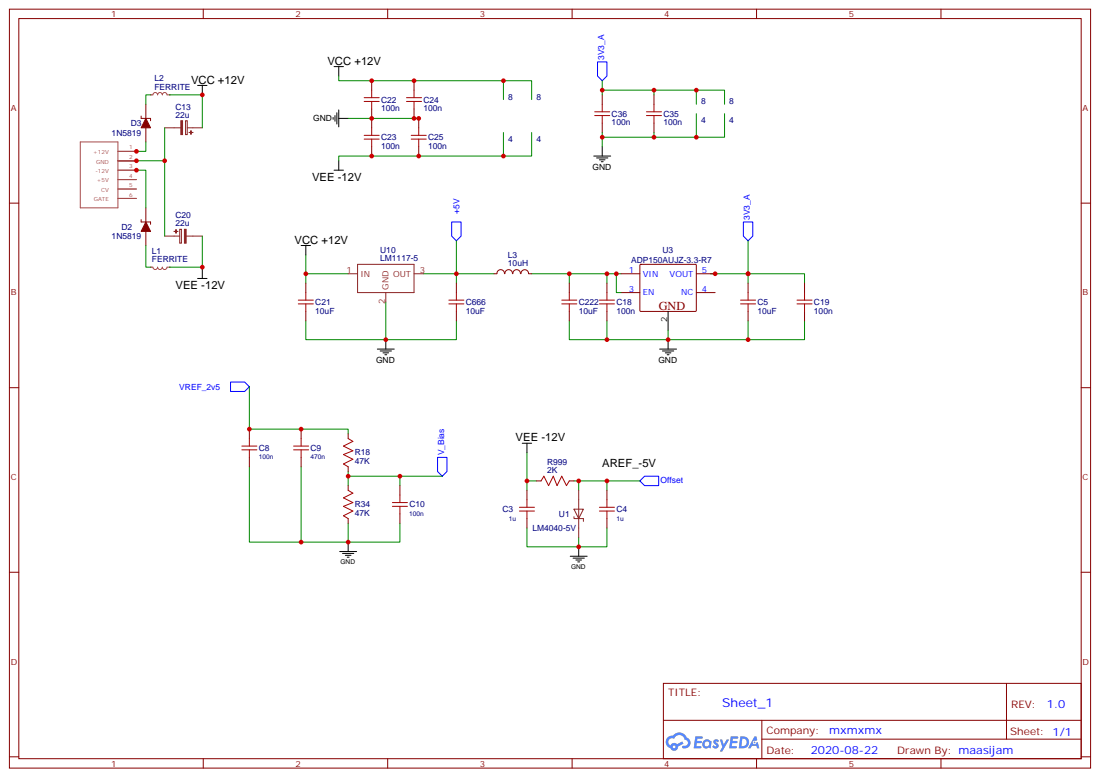
[picture p60: page 7]
