maasijam/MONOFA/(list of files, drawings)

Other design files:
MF-X1/EasyEDA/PCB_mfx1_panel_v1.0_revB_2026-10-12.json
MONOFA/EasyEDA/PCB_monofa_panel_v001_revE_2026-10-12.json
