maasijam/MONOFA/(commit log)

2022-04-10 Upload mf-x1 files
    [BOM_mf-x1_v1.0revB.csv]
2022-04-25 Upload monofa gerbers
2022-04-26 upload pcb screenshots
2022-05-29 Upload mf-x2 gerber files
2022-05-29 Upload Gerber Screens
2026-03-30 Added MF-X2 schematic and new screenshot
2026-03-30 Added modified ornament&crime software
    [Xen-harmonic.xlsx]
2026-04-02 Fixed wrong encoder direction
