maasijam/MONOFA/(notices)

Notices in the files:
MF-X2/software/o_c_REV_mf-x2/OC_DAC.cpp:
This program is free software: you can redistribute it and/or modify
it under the terms of version 3 of the GNU General Public License as
published by the Free Software Foundation at http://www.gnu.org/licenses,
with Additional Permissions under term 7(b) that the original copyright
